MisterHarbinger/VoxCaster/schematic.png

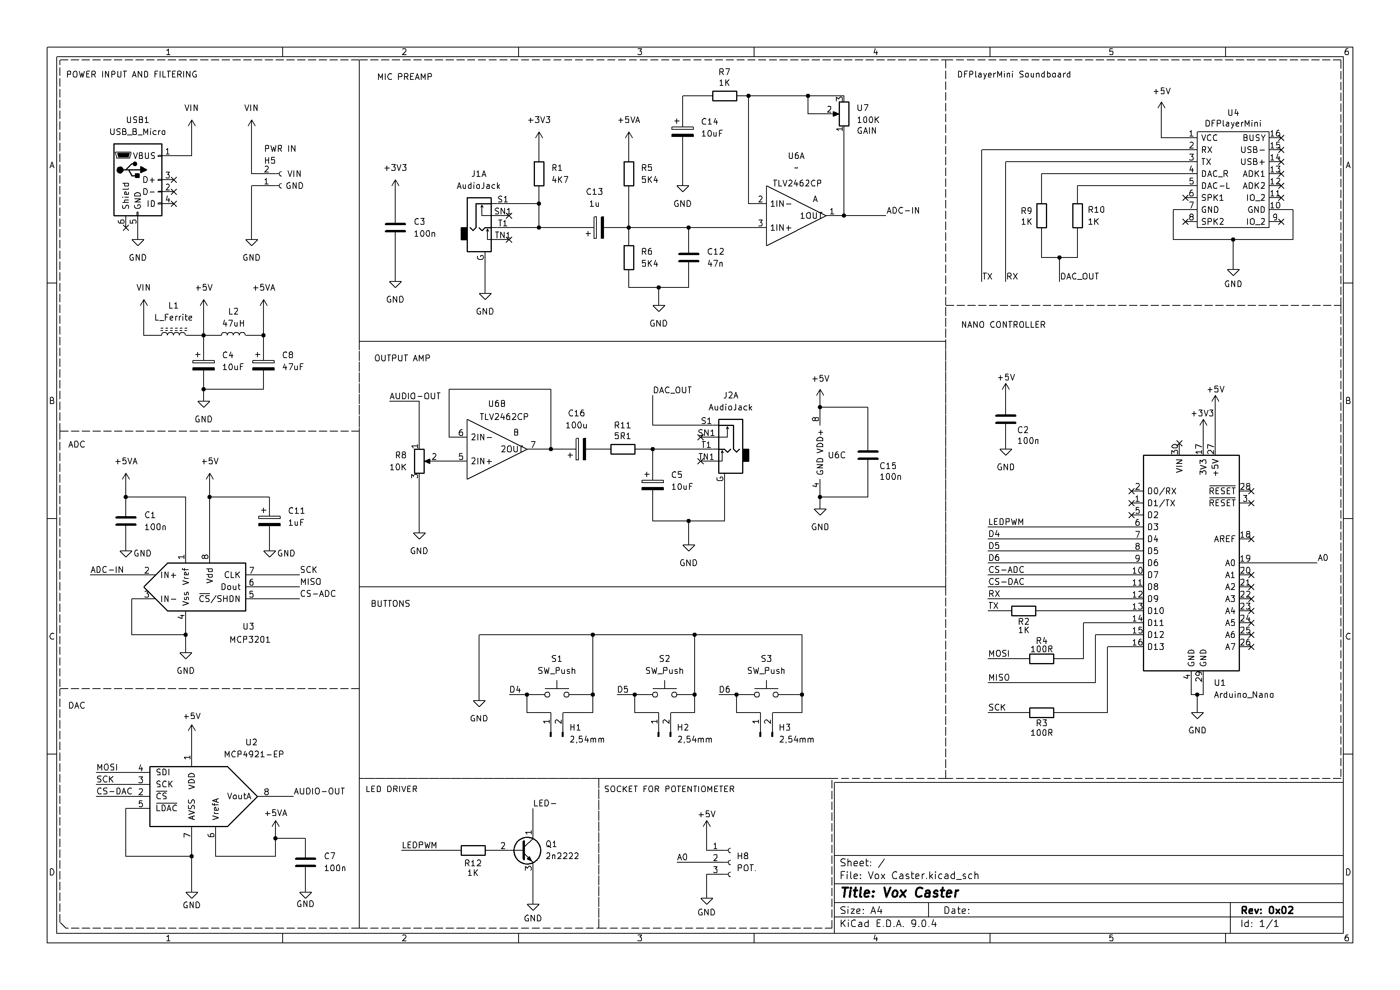
schematic.png
