MisterHarbinger/VoxCaster/schematic.pdf

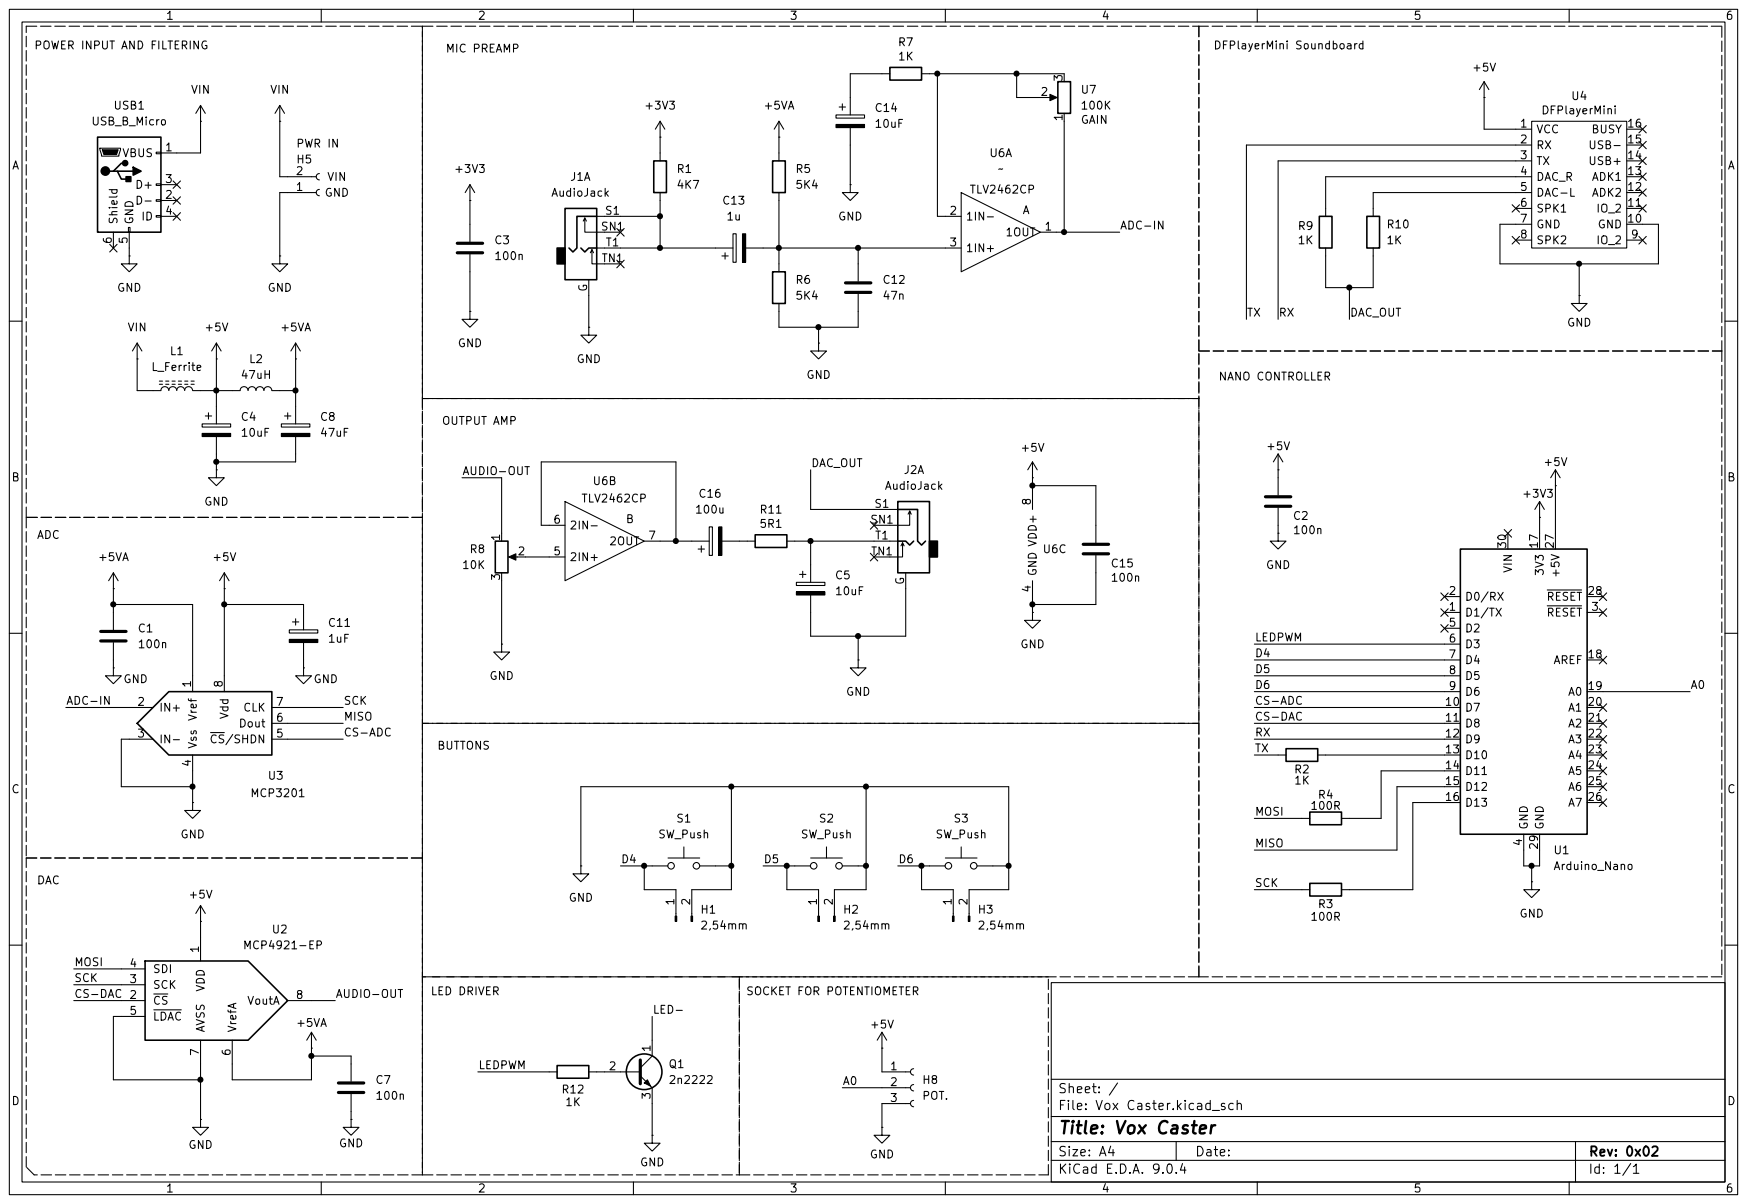
[picture p4: page 1]
