MisterHarbinger/VoxCaster/(commit log)

2025-08-28 Updated footprint for C12
2025-08-28 xlsx-version with formatting
    [component-list.xlsx]
2025-08-28 Update Vox-Caster.ino
    Along with latest "Gamble-exe:001-if-condition-optimization", made debounce-timer shared between all three buttons rather than button-specific.
